Sitengwu/IOT_Retro_Display_EEE4022S/3D Models/SplitFlap/Hour MainV2.3mf

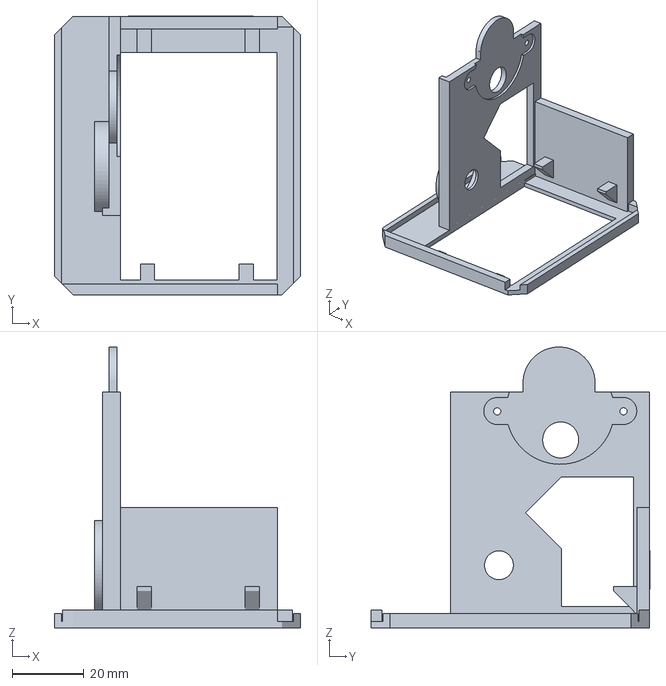
[picture p1: CAD file, 2024-11-08]
3D Models/SplitFlap/Hour MainV2.3mf
68.4 x 77.4 x 78.1 mm
