Sitengwu/IOT_Retro_Display_EEE4022S/3D Models/SplitFlap/STL/Hour Main.stl

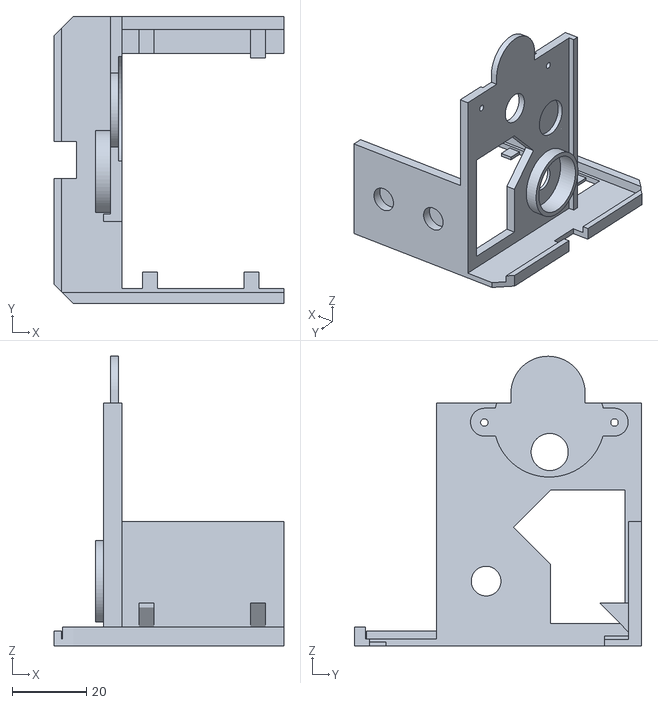
[picture p2: CAD file, 2024-11-08]
3D Models/SplitFlap/STL/Hour Main.stl
62.0 x 77.4 x 78.1
