Sitengwu/IOT_Retro_Display_EEE4022S/3D Models/SplitFlap/STL/Middle Gear Shaft Cap.stl

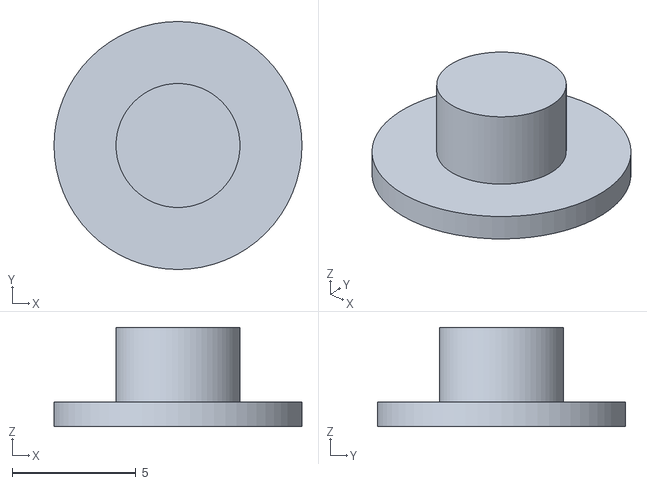
[picture p3: CAD file, 2024-11-08]
3D Models/SplitFlap/STL/Middle Gear Shaft Cap.stl
10.0 x 10.0 x 4.00
