Sitengwu/IOT_Retro_Display_EEE4022S/3D Models/LIXIE/STL/PowerModuleHousing.stl

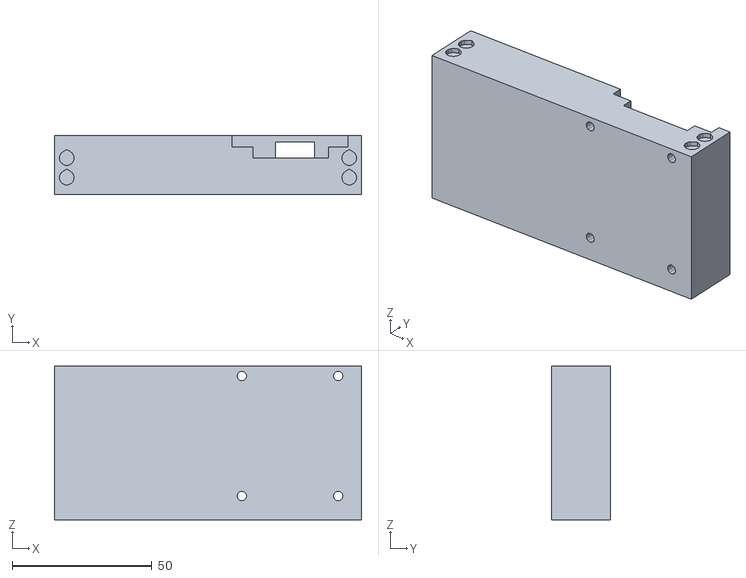
[picture p4: CAD file, 2024-11-08]
3D Models/LIXIE/STL/PowerModuleHousing.stl
110.0 x 21.0 x 55.0
