Sitengwu/IOT_Retro_Display_EEE4022S/3D Models/SplitFlap/STL/Motor Gear.stl

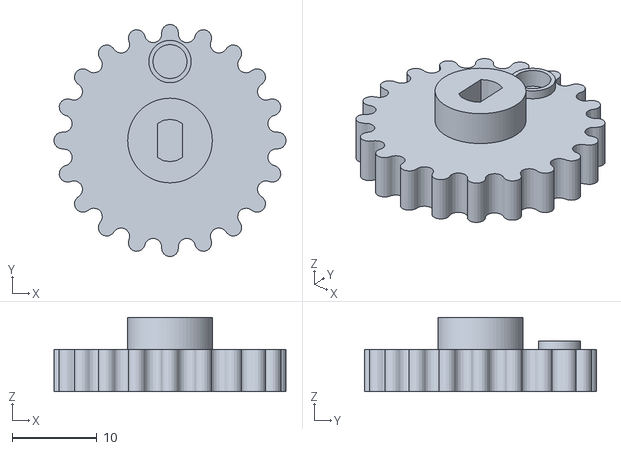
[picture p5: CAD file, 2024-11-08]
3D Models/SplitFlap/STL/Motor Gear.stl
27.4 x 27.4 x 8.80
