Sitengwu/IOT_Retro_Display_EEE4022S/3D Models/LIXIE/STL/DisplayModuleHousing.stl

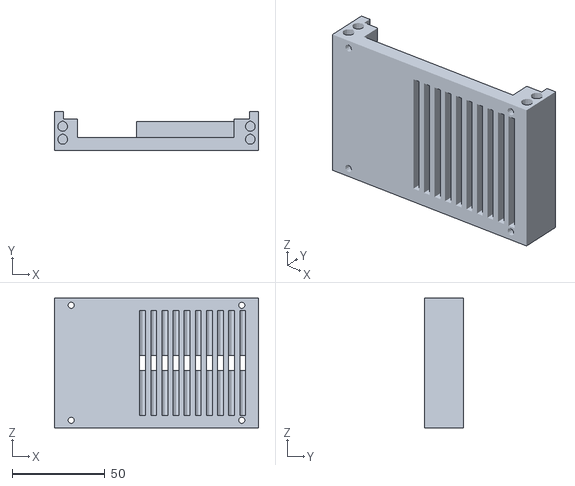
[picture p7: CAD file, 2024-11-08]
3D Models/LIXIE/STL/DisplayModuleHousing.stl
110.0 x 21.0 x 70.0
