Sitengwu/IOT_Retro_Display_EEE4022S/3D Models/SplitFlap/STL/Min-tens Flap.stl

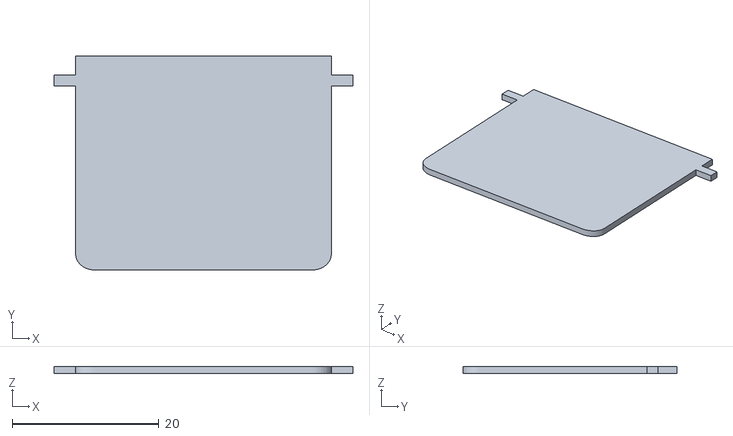
[picture p8: CAD file, 2024-11-08]
3D Models/SplitFlap/STL/Min-tens Flap.stl
40.8 x 29.2 x 1
