Sitengwu/IOT_Retro_Display_EEE4022S/3D Models/LIXIE/STL/DisplayModuleHousingCapV2.stl

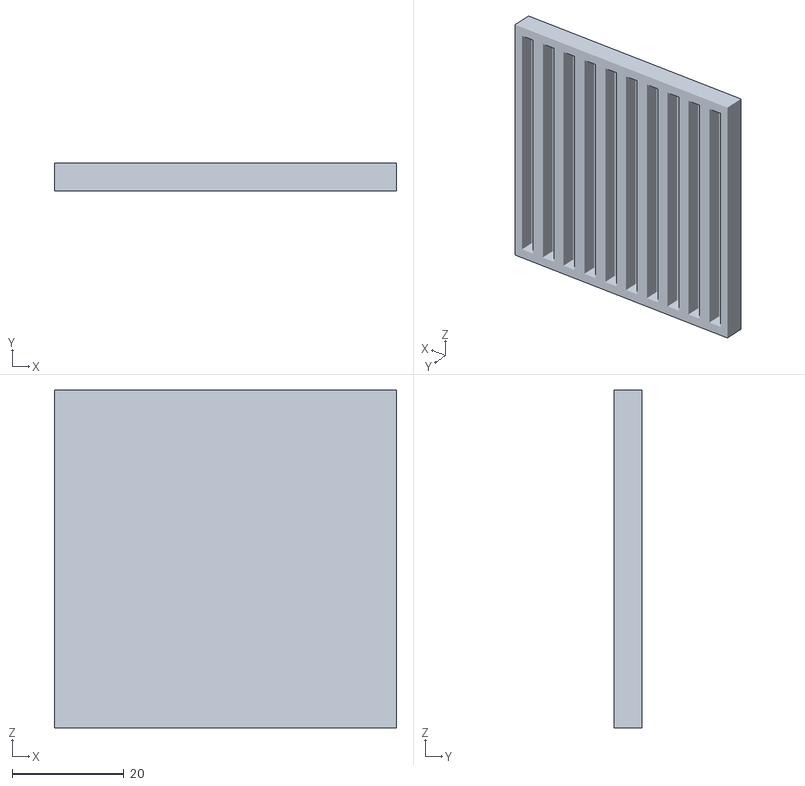
[picture p9: CAD file, 2024-11-08]
3D Models/LIXIE/STL/DisplayModuleHousingCapV2.stl
61.2 x 5.00 x 60.4
