Sitengwu/IOT_Retro_Display_EEE4022S/3D Models/SplitFlap/STL/Hour Crank.stl

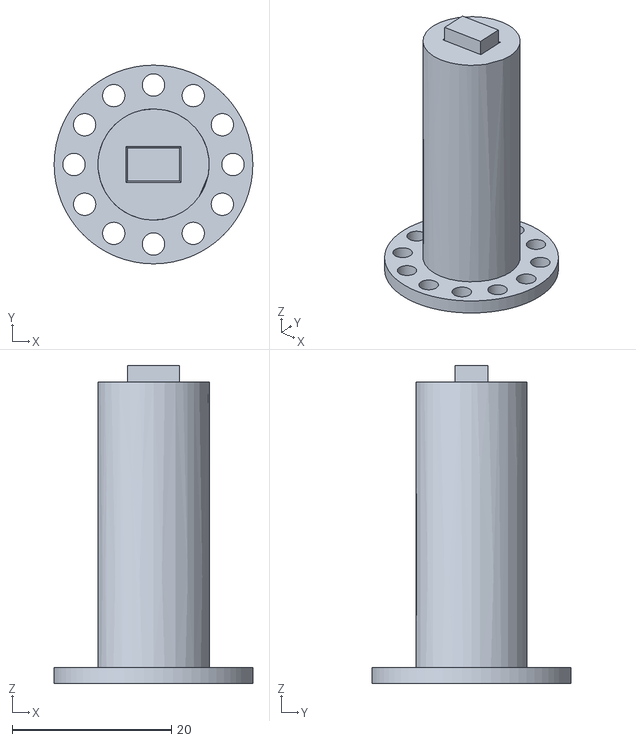
[picture p10: CAD file, 2024-11-08]
3D Models/SplitFlap/STL/Hour Crank.stl
25.0 x 25.0 x 40.0
