Sitengwu/IOT_Retro_Display_EEE4022S/3D Models/LIXIE/STL/DisplayModuleHousingV2.stl

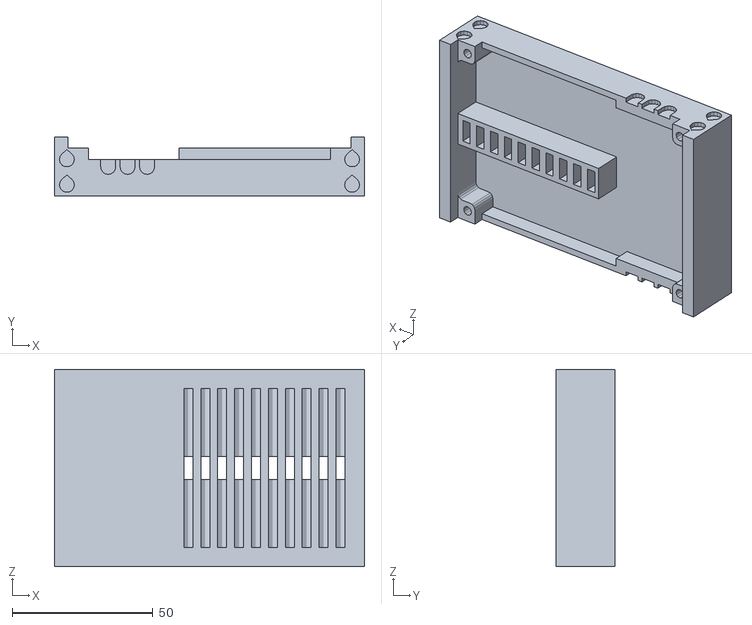
[picture p11: CAD file, 2024-11-08]
3D Models/LIXIE/STL/DisplayModuleHousingV2.stl
110.0 x 21.0 x 70.0
