Sitengwu/IOT_Retro_Display_EEE4022S/3D Models/SplitFlap/STL/Mintens Crank Close.stl

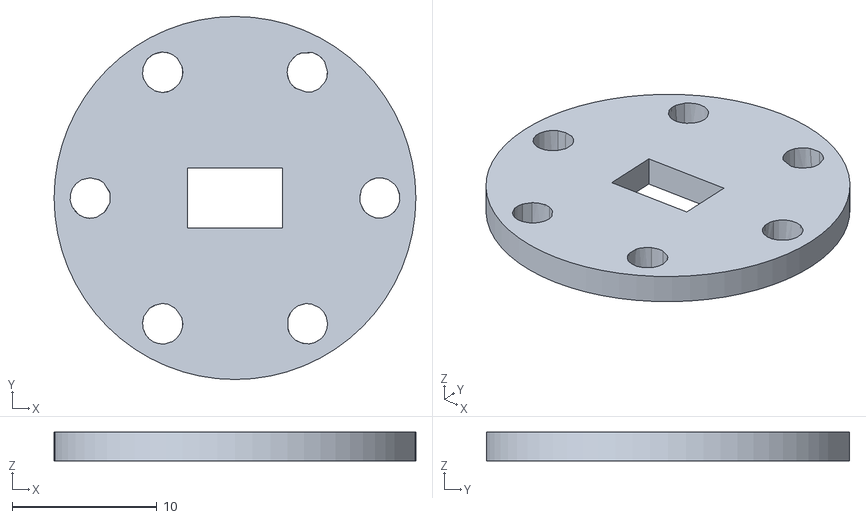
[picture p12: CAD file, 2024-11-08]
3D Models/SplitFlap/STL/Mintens Crank Close.stl
25.0 x 25.1 x 2.00
