Sitengwu/IOT_Retro_Display_EEE4022S/3D Models/SplitFlap/STL/Middle Gear.stl

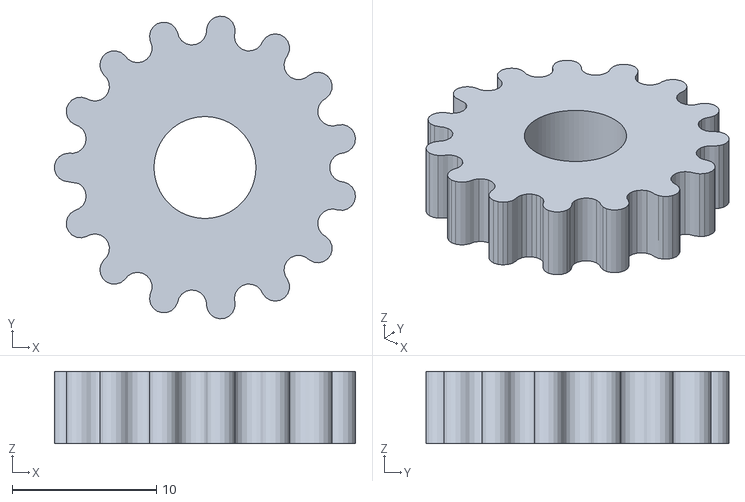
[picture p13: CAD file, 2024-11-08]
3D Models/SplitFlap/STL/Middle Gear.stl
20.9 x 21.0 x 5.00
