Sitengwu/IOT_Retro_Display_EEE4022S/3D Models/SplitFlap/STL/Crank Gear.stl

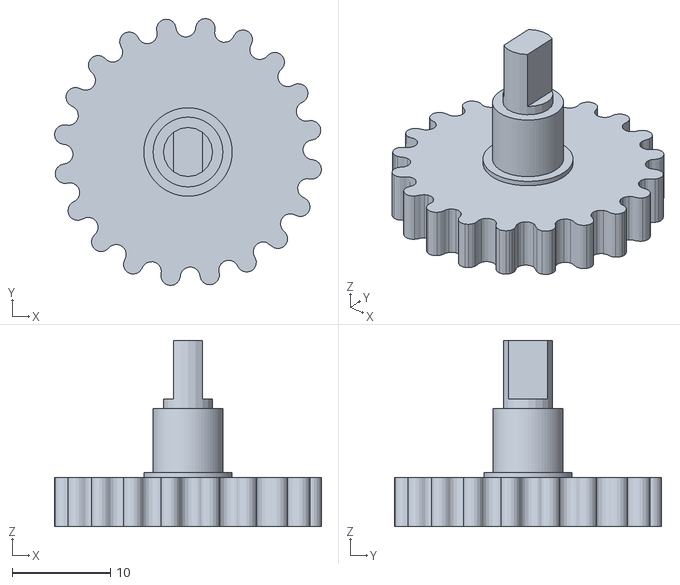
[picture p14: CAD file, 2024-11-08]
3D Models/SplitFlap/STL/Crank Gear.stl
27.2 x 27.2 x 19.0
