Sitengwu/IOT_Retro_Display_EEE4022S/3D Models/SplitFlap/STL/Hour Flap.stl

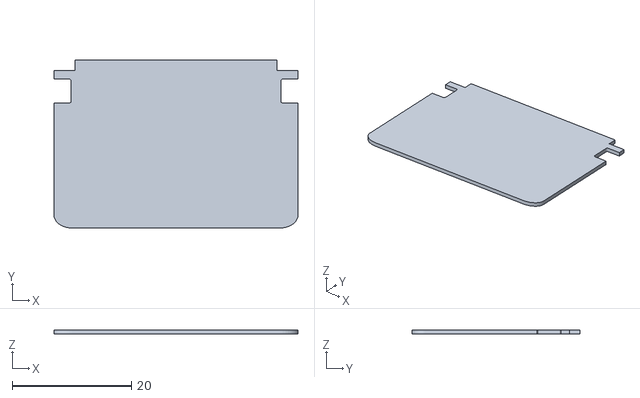
[picture p15: CAD file, 2024-11-08]
3D Models/SplitFlap/STL/Hour Flap.stl
41.0 x 28.2 x 0.75
