Sitengwu/IOT_Retro_Display_EEE4022S/3D Models/SplitFlap/STL/Bottom Plate.stl

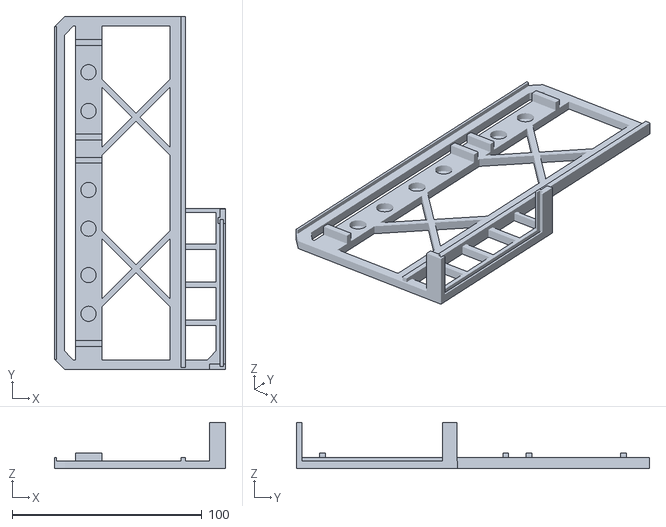
[picture p16: CAD file, 2024-11-08]
3D Models/SplitFlap/STL/Bottom Plate.stl
90.3 x 186.1 x 24.5
