Sitengwu/IOT_Retro_Display_EEE4022S/3D Models/SplitFlap/STL/Min Flap.stl

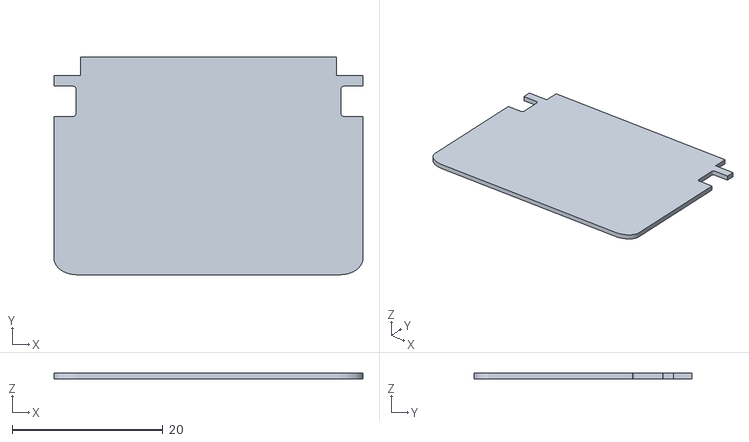
[picture p17: CAD file, 2024-11-08]
3D Models/SplitFlap/STL/Min Flap.stl
41.0 x 28.9 x 0.75
