Sitengwu/IOT_Retro_Display_EEE4022S/3D Models/SplitFlap/STL/Middle Gear Shaft.stl

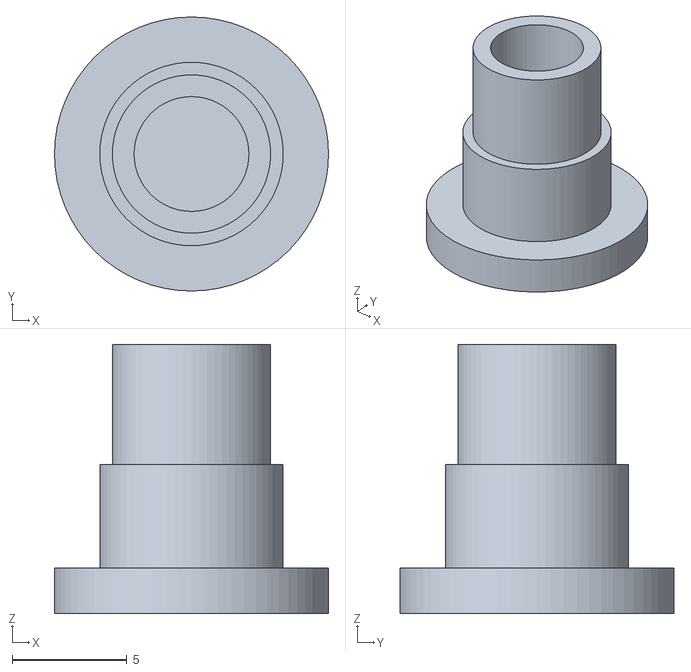
[picture p18: CAD file, 2024-11-08]
3D Models/SplitFlap/STL/Middle Gear Shaft.stl
11.9 x 11.9 x 11.8
