Sitengwu/IOT_Retro_Display_EEE4022S/3D Models/SplitFlap/STL/Hour FlapV2.stl

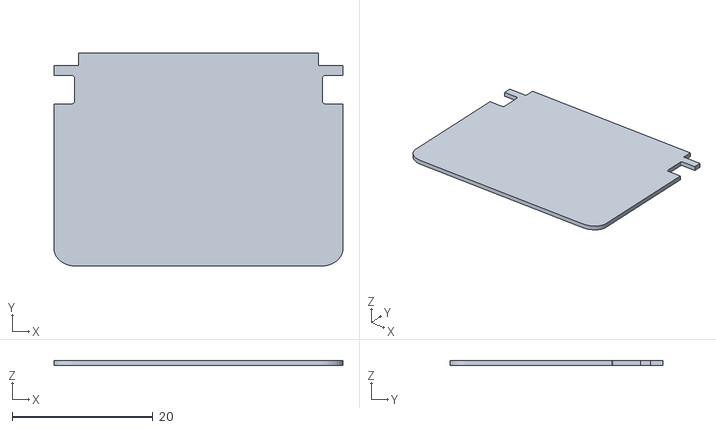
[picture p19: CAD file, 2024-11-08]
3D Models/SplitFlap/STL/Hour FlapV2.stl
41.0 x 30.2 x 0.75
