Sitengwu/IOT_Retro_Display_EEE4022S/3D Models/SplitFlap/STL/Mintens Crank.stl

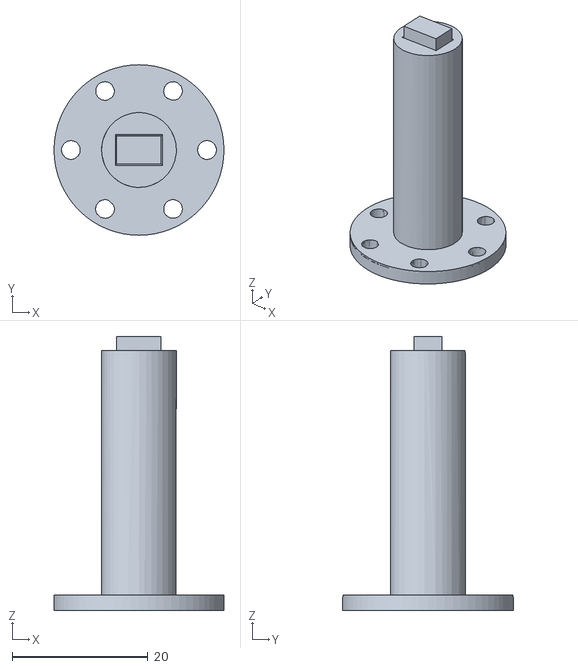
[picture p20: CAD file, 2024-11-08]
3D Models/SplitFlap/STL/Mintens Crank.stl
25.0 x 25.1 x 40.3
