Sitengwu/IOT_Retro_Display_EEE4022S/(list of files, cad)

Other CAD files:
3D Models/SplitFlap/STL/Mintens Main.stl
3D Models/LIXIE/Inventor IPT/789_Lines.dwg
3D Models/LIXIE/Inventor IPT/789outline.dwg
3D Models/LIXIE/Inventor IPT/Numbers.dwg
3D Models/LIXIE/Inventor IPT/NumbersV2.dwg
3D Models/LIXIE/Inventor IPT/789_frame.dwg
3D Models/LIXIE/Inventor IPT/NumbersFrame.dwg
3D Models/LIXIE/Inventor IPT/NumbersV2 Lines.dwg
3D Models/SplitFlap/STL/Hour Crank Close.stl
3D Models/LIXIE/Inventor IPT/789_Lines.ipt
3D Models/LIXIE/Inventor IPT/789_frame.ipt
3D Models/LIXIE/Inventor IPT/789outline.ipt
3D Models/LIXIE/Inventor IPT/AcrylicPane.ipt
3D Models/LIXIE/Inventor IPT/DisplayModuleAssembly.iam
3D Models/LIXIE/Inventor IPT/DisplayModuleHousing.ipt
3D Models/LIXIE/Inventor IPT/DisplayModuleHousingCap.ipt
3D Models/LIXIE/Inventor IPT/Numbers.ipt
3D Models/LIXIE/Inventor IPT/NumbersFrame.ipt
3D Models/LIXIE/Inventor IPT/NumbersV2 Lines.ipt
3D Models/LIXIE/Inventor IPT/NumbersV2.ipt
3D Models/LIXIE/Inventor IPT/PowerModuleHousing.ipt
3D Models/LIXIE/STL/DisplayModuleHousingCapV1.stl
3D Models/SplitFlap/STL/Hour MainV2.stl
