Sitengwu/IOT_Retro_Display_EEE4022S/KiCad/Panelised_PD+Display/NB Instructions.txt

Please select under PCB specifications: 

Different Designs:	2
Delivery Format:	Panel by Customer

Under PCB Assembly:

Tooling Holes: 		Added by Customer
