Sitengwu/IOT_Retro_Display_EEE4022S/KiCad/USB PD/USB PD.kicad_pcb

## KiCad design KiCad/USB PD/USB PD.kicad_pcb (2024-11-08)

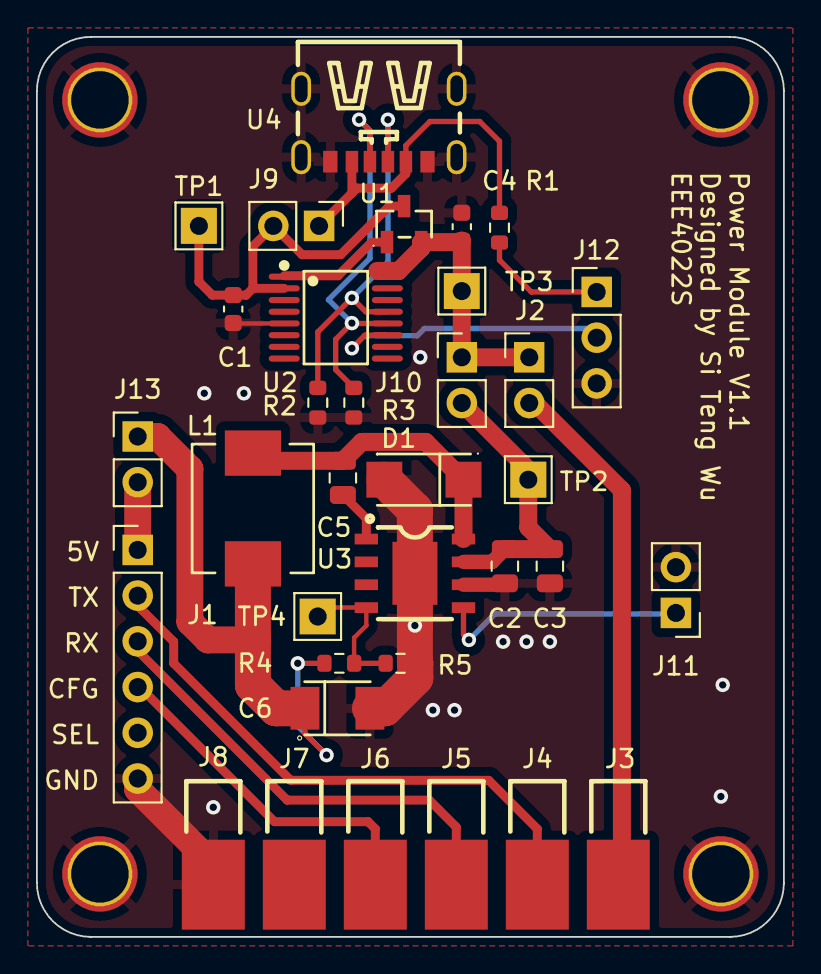
[picture p21: board USB PD.kicad_pcb from above]

Board: 2 copper layers, 41.5 x 50.0 mm, 38 parts (0 on the bottom side), 20 nets.

Parts:
C1: 1uF; C_0603_1608Metric
C2, C3: 4.7uF; C_0805_2012Metric
C4: 10uF; C_0603_1608Metric
C5: 10nF; C_0805_2012Metric
C6: 220uF; CAP-SMD_L3.5-W2.8
D1: SS34; SMA_L4.3-W2.6-LS5.2-RD
H1, H2, H3, H4: M3; MountingHole_3.2mm_M3_Pad_TopBottom
J1: ESP32 Jumpers; PinHeader_1x06_P2.54mm_Vertical
J2, J9, J10, J11, J13: Conn_01x02_Pin; PinHeader_1x02_P2.54mm_Vertical
J3: VCC; CONN-SMD_YZF0002-38080-02
J4: TX; CONN-SMD_YZF0002-38080-02
J5: RX; CONN-SMD_YZF0002-38080-02
J6: CFG; CONN-SMD_YZF0002-38080-02
J7: SEL; CONN-SMD_YZF0002-38080-02
J8: GND; CONN-SMD_YZF0002-38080-02
J12: Conn_01x03_Pin; PinHeader_1x03_P2.54mm_Vertical
L1: 22uH; IND-SMD_L7.3-W6.6_MHCI06030
R1: 100k; R_0603_1608Metric
R2, R3: 5.1k; R_0603_1608Metric
R4: 12k; R_0603_1608Metric
R5: 3.9k; R_0603_1608Metric
TP1, TP2, TP3, TP4: TestPoint; TestPoint_THTPad_2.0x2.0mm_Drill1.0mm
U1: AO3400A; SOT-23-3_L2.9-W1.3-P1.90-LS2.4-BR
U2: IP2721; TSSOP-16_L5.0-W4.4-P0.65-LS6.4-BL
U3: TPS5430DDAR; ESOP-8_L4.9-W3.9-P1.27-LS6.0-TL-EP
U4: TYPE-C_6P; TYPE-C-SMD_TYPE-C-6P

Connections:
/5V OUT: J1.1, J13.2
/USB_C_VIN: J9.1, R1.1, U4.A9 (VBUS), U4.B9 (VBUS)
/USB_C_VOUT: C4.1, J2.1, J10.1, TP3.1, U1.2 (S), U2.16 (VBUS)
GND: C1.2, C2.2, C3.2, C4.2, C6.2, D1.2 (A), H1.1, H2.1, H3.1, H4.1, J1.6, J8.1, J11.2, J12.3, R2.2, R3.2, R5.2, U2.5 (GND), U3.6 (GND), U3.9 (PowerPAD), U4.7 (EH), U4.A12 (GND), U4.B12 (GND)
unnamed: C5.1, D1.1 (K), L1.1, U3.8 (PH)
unnamed: J1.2, J4.1
unnamed: J1.3, J5.1
unnamed: J1.4, J6.1
unnamed: J2.2, J3.1
unnamed: C1.1, J9.2, TP1.1, U1.3 (D), U2.2 (VIN)
unnamed: C2.1, C3.1, J10.2, TP2.1, U3.7 (VIN)
unnamed: J11.1, U3.5 (ENA)
unnamed: J12.1, R1.2
unnamed: J12.2, U2.11 (SEL)
unnamed: C6.1, J13.1, L1.2, R4.1
unnamed: U1.1 (G), U2.1 (VBUSG)
unnamed: R2.1, U2.13 (CC1), U4.A5 (CC1)
unnamed: R3.1, U2.12 (CC2), U4.B5 (CC2)
unnamed: C5.2, U3.1 (BOOT)
unnamed: R4.2, R5.1, TP4.1, U3.4 (VSENSE)
