Sitengwu/IOT_Retro_Display_EEE4022S/KiCad/Retro Display Module/Retro Display Module.kicad_pcb

## KiCad design KiCad/Retro Display Module/Retro Display Module.kicad_pcb (2024-10-01)

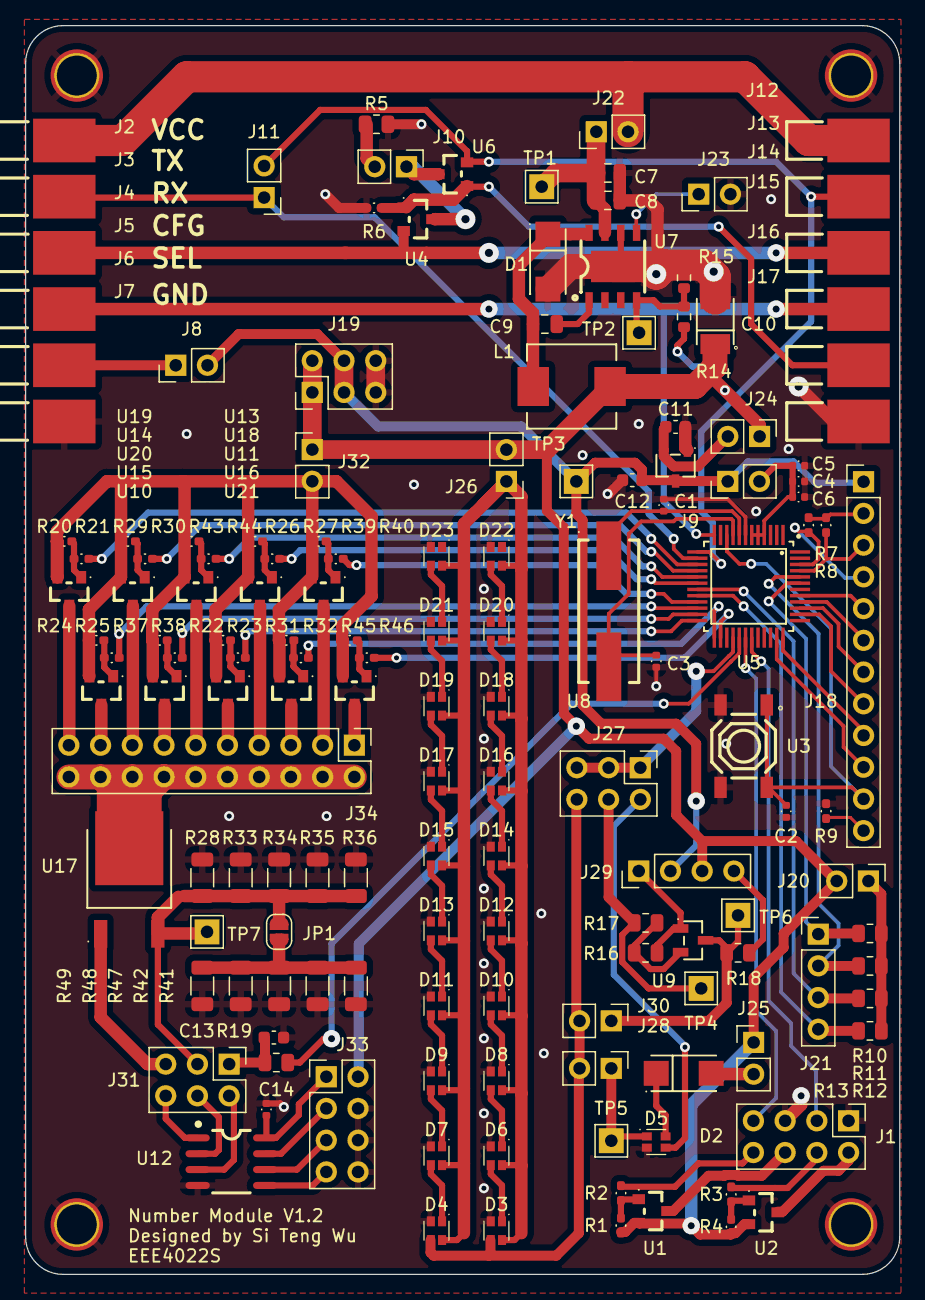
[picture p22: board Retro Display Module.kicad_pcb from above]

Board: 2 copper layers, 70.0 x 100.0 mm, 155 parts (0 on the bottom side), 119 nets.

Parts:
C1, C3: 10pF; C_0402_1005Metric
C2, C4, C6, C14: 0.1uF; C_0402_1005Metric
C5: 4.7uF; C_0402_1005Metric
C7, C8: 4.7uF; C_0805_2012Metric
C9: 10nF; C_0805_2012Metric
C10: 220uF; CAP-SMD_L3.5-W2.8
C11, C12, C13: 1uF; C_0603_1608Metric
D1: SS34; SMA_L4.3-W2.6-LS5.2-RD
D2: M7; SMA_L4.3-W2.6-LS5.2-RD
D3, D4, D5, D6, D7, D8, D9, D10, D11, D12, D13, D14, D15, D16, D17, D18, D19, D20, D21, D22, D23: XL-1615RGBC-WS2812B; LED-SMD_4P-L1.6-W1.5_XL-1615RGBC-WS2812B
H1, H2, H3, H4: M3; MountingHole_3.2mm_M3_Pad_TopBottom
J1, J33: Conn_02x04_Odd_Even; PinHeader_2x04_P2.54mm_Vertical
J2, J12: VCC; CONN-SMD_YZF0002-38080-02
J3, J13: TX; CONN-SMD_YZF0002-38080-02
J4, J14: RX; CONN-SMD_YZF0002-38080-02
J5, J15: CFG; CONN-SMD_YZF0002-38080-02
J6, J16: SEL; CONN-SMD_YZF0002-38080-02
J7, J17: GND; CONN-SMD_YZF0002-38080-02
J8, J9, J10, J11, J20, J22, J23, J24, J25, J26, J28, J30, J32: Conn_01x02_Pin; PinHeader_1x02_P2.54mm_Vertical
J18: Conn_01x12_Pin; PinHeader_1x12_P2.54mm_Vertical
J19, J27, J31: Conn_02x03_Odd_Even; PinHeader_2x03_P2.54mm_Vertical
J21, J29: Conn_01x04_Pin; PinHeader_1x04_P2.54mm_Vertical
J34: Conn_02x11_Odd_Even; PinHeader_2x10_P2.54mm_Vertical
JP1: Jumper_2_Open; SolderJumper-2_P1.3mm_Open_RoundedPad1.0x1.5mm
L1: 22uH; IND-SMD_L7.3-W6.6_MHCI06030
R1, R4, R6, R20, R22, R24, R26, R29, R31, R37, R39, R43, R45: 100k; R_0402_1005Metric_Pad0.72x0.64mm_HandSolder
R2, R3, R21, R23, R25, R27, R30, R32, R38, R40, R44, R46: 1k; R_0402_1005Metric_Pad0.72x0.64mm_HandSolder
R5, R16, R17, R18: 1k; R_0805_2012Metric
R7, R8, R9: 10k; R_0402_1005Metric_Pad0.72x0.64mm_HandSolder
R10, R11, R12, R13: 4.7k; R_0805_2012Metric
R14: 12k; R_0603_1608Metric
R15: 3.9k; R_0603_1608Metric
R19: 10k; R_0805_2012Metric
R28, R33, R34, R35, R36, R41, R42, R47, R48, R49: 100; R_1206_3216Metric
TP1, TP2, TP3, TP4, TP5, TP6, TP7: TestPoint; TestPoint_THTPad_2.0x2.0mm_Drill1.0mm
U1, U2, U4, U6, U10, U11, U13, U14, U15, U16, U18, U19, U20, U21: AO3401A; SOT-23_L2.9-W1.3-P1.90-LS2.4-BR
U3: TS-1187A-B-A-B; SW-SMD_4P-L5.1-W5.1-P3.70-LS6.5-TL-2
U5: STM32G030C8T6; LQFP-48_L7.0-W7.0-P0.50-LS9.0-BL_1
U7: TPS5430DDAR; ESOP-8_L4.9-W3.9-P1.27-LS6.0-TL-EP
U8: XC6206P332MR; XC6206
U9: 2N7002; SOT-23-3_L2.9-W1.3-P1.90-LS2.4-BR
U12: LM358DR2G; Dual LM358
U17: MJD44H11J; MJD44 NPN
Y1: Crystal; CRYSTAL-SMD_L11.5-W4.8-LS12.7

Connections:
/3V3: C12.1, J8.2, J9.1, J18.1, J19.3, J19.4, J29.2, TP3.1, U8.3 (Vout)
/5V: C10.1, J19.1, J19.2, J20.2, J24.1, J25.1, J26.2, J29.3, J32.1, J33.2, L1.2, R1.1, R4.1, R14.1, U1.2 (S), U2.2 (S)
/I2C1_SCL: J18.3, R8.2, U5.45 (PB6)
/I2C1_SDA: J18.4, R7.2, U5.46 (PB7)
/I2C_PUR: J18.2, R7.1, R8.1
/LED Driver/1OUT: J31.5, U17.1 (B)
/LED Driver/5V_PWR: J32.2, R20.1, R22.1, R24.1, R26.1, R29.1, R31.1, R37.1, R39.1, R43.1, R45.1, U10.2 (S), U11.2 (S), U13.2 (S), U14.2 (S), U15.2 (S), U16.2 (S), U18.2 (S), U19.2 (S), U20.2 (S), U21.2 (S)
/LED Driver/-ve: J31.3, JP1.1 (A), R28.1, R33.1, R34.1, R35.1, R36.1, TP7.1, U17.3 (E)
/LED Driver/LED0: J34.1, U21.3 (D)
/LED Driver/LED1: J34.19, U10.3 (D)
/LED Driver/LED2: J34.17, U13.3 (D)
/LED Driver/LED3: J34.15, U15.3 (D)
/LED Driver/LED4: J34.13, U18.3 (D)
/LED Driver/LED5: J34.11, U20.3 (D)
/LED Driver/LED6: J34.9, U11.3 (D)
/LED Driver/LED7: J34.7, U14.3 (D)
/LED Driver/LED8: J34.5, U16.3 (D)
/LED Driver/LED9: J34.3, U19.3 (D)
/LED Driver/main_col: J34.2, J34.4, J34.6, J34.8, J34.10, J34.12, J34.14, J34.16, J34.18, J34.20, U17.2 (C)
/NRST: C2.1, J18.11, U3.1 (A), U3.2 (B), U5.10 (NRST)
/PA1: J5.1, J15.1, U5.12 (PA1)
/PA4: R21.2, U5.15 (PA4)
/PA5: R30.2, U5.16 (PA5)
/PA6: R44.2, U5.17 (PA6)
/PA7: R27.2, U5.18 (PA7)
/PB2: R40.2, U5.21 (PB2)
/PB10: R25.2, U5.22 (PB10)
/PB11: R38.2, U5.23 (PB11)
/PB12: R23.2, U5.24 (PB12)
/PB13: R32.2, U5.25 (PB13)
/PB14: R46.2, U5.26 (PB14)
/PC6: J1.8, R2.2
/PC7: J1.4, R3.2
/PD1: J18.7, U5.39 (PD1)
/PD2: J18.6, U5.40 (PD2)
/PD3: J18.5, U5.41 (PD3)
/PDO: J18.8, U5.38 (PD0)
/RGB LEDs/Cheese: D5.4 (DI), J27.2
/RGB LEDs/DIN: D3.4 (DI), D4.4 (DI), J27.6, J28.2, J30.2
/RGB LEDs/Level: J27.4, R16.2, TP4.1
/SWDCLK/BOOT: J18.9, U5.36 (PA14-BOOT0)
/SWDIO: J18.10, U5.35 (PA13)
/TIM1_CH1: J27.1, J27.3, J27.5, U5.28 (PA8)
/TIM1_CH2: R19.2, U5.29 (PA9)
/TIM3_CH1: J21.1, R10.2, U5.43 (PB4)
/TIM3_CH2: J21.2, R11.2, U5.44 (PB5)
/TIM3_CH3: J21.3, R12.2, U5.19 (PB0)
/TIM3_CH4: J21.4, R13.2, U5.20 (PB1)
/USART2_Rx: J3.1, J11.1, U5.14 (PA3)
/USART2_Tx: J11.2, J13.1, U5.13 (PA2), U6.2 (S)
/VCC: J2.1, J12.1, J22.2
/VR/B: C4.1, C5.1, C6.1, J9.2, U5.4 (VBAT), U5.5 (VREF+), U5.6 (VDDA/DDA)
GND: C1.2, C2.2, C3.2, C4.2, C5.2, C6.2, C7.2, C8.2, C10.2, C11.2, C12.2, C13.2, C14.2, D1.2 (A), D3.3 (GND), D4.3 (GND), D5.3 (GND), D6.3 (GND), D7.3 (GND), D8.3 (GND), D9.3 (GND), D10.3 (GND), D11.3 (GND), D12.3 (GND), D13.3 (GND), D14.3 (GND), D15.3 (GND), D16.3 (GND), D17.3 (GND), D18.3 (GND), D19.3 (GND), D20.3 (GND), D21.3 (GND), D22.3 (GND), D23.3 (GND), H1.1, H2.1, H3.1, H4.1, J1.1, J1.5, J7.1, J17.1, J19.5, J19.6, J23.2, J33.4, J33.6, J33.8, R5.2, R6.2, R9.1, R15.2, R28.2, R33.2, R34.2, R35.2, R36.2, R41.2, R42.2, R47.2, R48.2, R49.2, U3.3 (C), U3.4 (D), U5.7 (VSSA/SSA), U7.6 (GND), U7.9 (PowerPAD), U8.1 (GND), U12.4 (GND)
unnamed: C9.1, D1.1 (K), L1.1, U7.8 (PH)
unnamed: D2.2 (A), J25.2
unnamed: D2.1 (K), D5.2 (VDD)
unnamed: D3.1 (DO), D6.4 (DI)
unnamed: D4.1 (DO), D7.4 (DI)
unnamed: D5.1 (DO), J28.1, TP5.1
unnamed: D6.1 (DO), D8.4 (DI)
unnamed: D7.1 (DO), D9.4 (DI)
unnamed: D8.1 (DO), D10.4 (DI)
unnamed: D10.1 (DO), D12.4 (DI)
unnamed: D3.2 (VDD), D4.2 (VDD), D6.2 (VDD), D7.2 (VDD), D8.2 (VDD), D9.2 (VDD), D10.2 (VDD), D11.2 (VDD), D12.2 (VDD), D13.2 (VDD), D14.2 (VDD), D15.2 (VDD), D16.2 (VDD), D17.2 (VDD), D18.2 (VDD), D19.2 (VDD), D20.2 (VDD), D21.2 (VDD), D22.2 (VDD), D23.2 (VDD), J26.1
unnamed: D9.1 (DO), D11.4 (DI)
unnamed: D11.1 (DO), D13.4 (DI)
unnamed: D12.1 (DO), D14.4 (DI)
unnamed: D13.1 (DO), D15.4 (DI)
unnamed: D14.1 (DO), D16.4 (DI)
unnamed: D15.1 (DO), D17.4 (DI)
unnamed: D16.1 (DO), D18.4 (DI)
unnamed: D17.1 (DO), D19.4 (DI)
unnamed: D18.1 (DO), D20.4 (DI)
unnamed: D19.1 (DO), D21.4 (DI)
unnamed: D20.1 (DO), D22.4 (DI)
unnamed: D21.1 (DO), D23.4 (DI)
unnamed: J1.2, U2.3 (D)
unnamed: J1.3, U5.31 (PC7)
unnamed: J1.6, U1.3 (D)
unnamed: J1.7, U5.30 (PC6)
unnamed: J6.1, J8.1
unnamed: J10.1, U4.3 (D), U6.3 (D)
unnamed: J10.2, R5.1
unnamed: J4.1, J14.1, U4.2 (S)
unnamed: J16.1, R6.1, U4.1 (G), U6.1 (G)
unnamed: J18.12, R9.2
unnamed: J20.1, R10.1, R11.1, R12.1, R13.1
unnamed: C7.1, C8.1, J22.1, TP1.1, U7.7 (VIN)
unnamed: J23.1, U7.5 (ENA)
unnamed: C11.1, J24.2, U8.2 (Vin)
unnamed: J29.1, R17.2, U9.1 (G)
unnamed: J29.4, R18.2
unnamed: J30.1, R18.1, TP6.1, U9.3 (D)
unnamed: C13.1, J31.1, R19.1
unnamed: J31.2, U12.3 (1IN+)
unnamed: J31.4, U12.2 (1IN-)
unnamed: J31.6, U12.1 (1OUT)
unnamed: C14.1, J33.1, U12.8 (VCC)
unnamed: J33.3, U12.7 (2OUT)
unnamed: J33.5, U12.6 (2IN-)
unnamed: J33.7, U12.5 (2IN+)
unnamed: JP1.2 (B), R41.1, R42.1, R47.1, R48.1, R49.1
unnamed: R1.2, R2.1, U1.1 (G)
unnamed: R3.1, R4.2, U2.1 (G)
unnamed: C1.1, U5.8 (PF0-OSC_IN), Y1.1
unnamed: C3.1, U5.9 (PF1-OSC_OUT), Y1.2
unnamed: C9.2, U7.1 (BOOT)
unnamed: R14.2, R15.1, TP2.1, U7.4 (VSENSE)
unnamed: R16.1, R17.1, U9.2 (S)
unnamed: R20.2, R21.1, U10.1 (G)
unnamed: R22.2, R23.1, U11.1 (G)
unnamed: R24.2, R25.1, U13.1 (G)
unnamed: R26.2, R27.1, U14.1 (G)
unnamed: R29.2, R30.1, U15.1 (G)
unnamed: R31.2, R32.1, U16.1 (G)
unnamed: R37.2, R38.1, U18.1 (G)
unnamed: R39.2, R40.1, U19.1 (G)
unnamed: R43.2, R44.1, U20.1 (G)
unnamed: R45.2, R46.1, U21.1 (G)
