Sitengwu/IOT_Retro_Display_EEE4022S/KiCad/Panelised_PD+Display/Panelised_PD+Display.kicad_pcb

## KiCad design KiCad/Panelised_PD+Display/Panelised_PD+Display.kicad_pcb (2024-10-01)

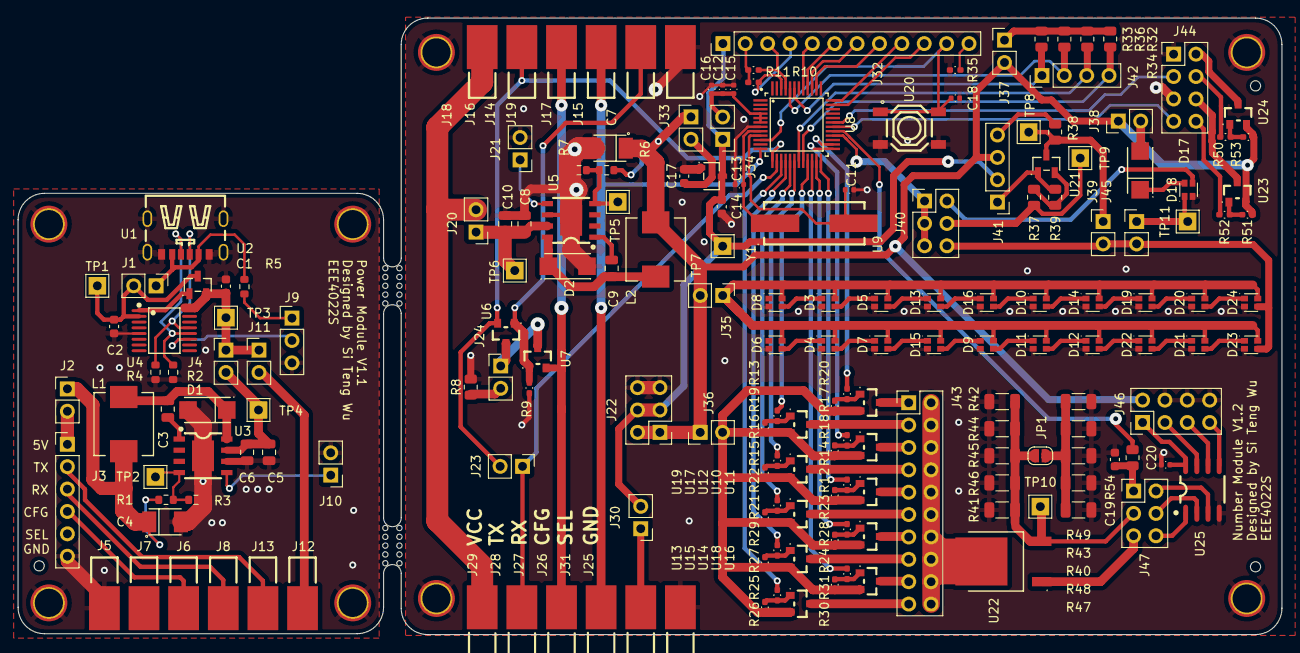
[picture p23: board Panelised_PD+Display.kicad_pcb from above]

Board: 2 copper layers, 143.5 x 70.0 mm, 195 parts (0 on the bottom side), 133 nets.

Parts:
C1: 10uF; C_0603_1608Metric
C2, C14, C17, C19: 1uF; C_0603_1608Metric
C3, C9: 10nF; C_0805_2012Metric
C4, C7: 220uF; CAP-SMD_L3.5-W2.8
C5, C6, C8, C10: 4.7uF; C_0805_2012Metric
C11, C13: 10pF; C_0402_1005Metric
C12, C15, C18, C20: 0.1uF; C_0402_1005Metric
C16: 4.7uF; C_0402_1005Metric
D1, D2: SS34; SMA_L4.3-W2.6-LS5.2-RD
D3, D4, D5, D6, D7, D8, D9, D10, D11, D12, D13, D14, D15, D16, D18, D19, D20, D21, D22, D23, D24: XL-1615RGBC-WS2812B; LED-SMD_4P-L1.6-W1.5_XL-1615RGBC-WS2812B
D17: M7; SMA_L4.3-W2.6-LS5.2-RD
H1, H2, H3, H4, H5, H6, H7, H8: M3; MountingHole_3.2mm_M3_Pad_TopBottom
J1, J2, J4, J10, J11, J20, J21, J23, J24, J30, J33, J34, J35, J36, J37, J38, J39, J45: Conn_01x02_Pin; PinHeader_1x02_P2.54mm_Vertical
J3: ESP32 Jumpers; PinHeader_1x06_P2.54mm_Vertical
J5, J15, J25: GND; CONN-SMD_YZF0002-38080-02
J6, J19, J26: CFG; CONN-SMD_YZF0002-38080-02
J7, J17, J31: SEL; CONN-SMD_YZF0002-38080-02
J8, J14, J27: RX; CONN-SMD_YZF0002-38080-02
J9: Conn_01x03_Pin; PinHeader_1x03_P2.54mm_Vertical
J12, J18, J29: VCC; CONN-SMD_YZF0002-38080-02
J13, J16, J28: TX; CONN-SMD_YZF0002-38080-02
J22, J40, J47: Conn_02x03_Odd_Even; PinHeader_2x03_P2.54mm_Vertical
J32: Conn_01x12_Pin; PinHeader_1x12_P2.54mm_Vertical
J41, J42: Conn_01x04_Pin; PinHeader_1x04_P2.54mm_Vertical
J43: Conn_02x11_Odd_Even; PinHeader_2x10_P2.54mm_Vertical
J44, J46: Conn_02x04_Odd_Even; PinHeader_2x04_P2.54mm_Vertical
JP1: Jumper_2_Open; SolderJumper-2_P1.3mm_Open_RoundedPad1.0x1.5mm
L1, L2: 22uH; IND-SMD_L7.3-W6.6_MHCI06030
R1, R6: 12k; R_0603_1608Metric
R2, R4: 5.1k; R_0603_1608Metric
R3, R7: 3.9k; R_0603_1608Metric
R5: 100k; R_0603_1608Metric
R8, R37, R38, R39: 1k; R_0805_2012Metric
R9, R14, R15, R17, R19, R21, R23, R24, R26, R27, R30, R51, R53: 100k; R_0402_1005Metric_Pad0.72x0.64mm_HandSolder
R10, R11, R35: 10k; R_0402_1005Metric_Pad0.72x0.64mm_HandSolder
R12, R13, R16, R18, R20, R22, R25, R28, R29, R31, R50, R52: 1k; R_0402_1005Metric_Pad0.72x0.64mm_HandSolder
R32, R33, R34, R36: 4.7k; R_0805_2012Metric
R40, R41, R42, R43, R44, R45, R46, R47, R48, R49: 100; R_1206_3216Metric
R54: 10k; R_0805_2012Metric
TP1, TP2, TP3, TP4, TP5, TP6, TP7, TP8, TP9, TP10, TP11: TestPoint; TestPoint_THTPad_2.0x2.0mm_Drill1.0mm
U1: TYPE-C_6P; TYPE-C-SMD_TYPE-C-6P
U2: AO3400A; SOT-23-3_L2.9-W1.3-P1.90-LS2.4-BR
U3, U5: TPS5430DDAR; ESOP-8_L4.9-W3.9-P1.27-LS6.0-TL-EP
U4: IP2721; TSSOP-16_L5.0-W4.4-P0.65-LS6.4-BL
U6, U7, U10, U11, U12, U13, U14, U15, U16, U17, U18, U19, U23, U24: AO3401A; SOT-23_L2.9-W1.3-P1.90-LS2.4-BR
U8: STM32G030C8T6; LQFP-48_L7.0-W7.0-P0.50-LS9.0-BL_1
U9: XC6206P332MR; XC6206
U20: TS-1187A-B-A-B; SW-SMD_4P-L5.1-W5.1-P3.70-LS6.5-TL-2
U21: 2N7002; SOT-23-3_L2.9-W1.3-P1.90-LS2.4-BR
U22: MJD44H11J; MJD44 NPN
U25: LM358DR2G; Dual LM358
Y1: Crystal; CRYSTAL-SMD_L11.5-W4.8-LS12.7
mouse-bite-1, mouse-bite-2: VAL**; mouse-bite-2mm-slot

Connections:
/3V3: C14.1, J22.3, J22.4, J30.2, J32.1, J34.1, J41.2, TP7.1, U9.3 (Vout)
/5V: C7.1, J22.1, J22.2, J33.1, J35.2, J36.1, J37.2, J38.1, J41.3, J46.2, L2.2, R6.1, R51.1, R53.1, U23.2 (S), U24.2 (S)
/5V OUT: J2.2, J3.1
/I2C1_SCL: J32.3, R10.2, U8.45 (PB6)
/I2C1_SDA: J32.4, R11.2, U8.46 (PB7)
/I2C_PUR: J32.2, R10.1, R11.1
/LED Driver/1OUT: J47.5, U22.1 (B)
/LED Driver/5V_PWR: J36.2, R14.1, R15.1, R17.1, R19.1, R21.1, R23.1, R24.1, R26.1, R27.1, R30.1, U10.2 (S), U11.2 (S), U12.2 (S), U13.2 (S), U14.2 (S), U15.2 (S), U16.2 (S), U17.2 (S), U18.2 (S), U19.2 (S)
/LED Driver/-ve: J47.3, JP1.1 (A), R41.1, R42.1, R44.1, R45.1, R46.1, TP10.1, U22.3 (E)
/LED Driver/LED0: J43.1, U11.3 (D)
/LED Driver/LED1: J43.19, U16.3 (D)
/LED Driver/LED2: J43.17, U19.3 (D)
/LED Driver/LED3: J43.15, U18.3 (D)
/LED Driver/LED4: J43.13, U17.3 (D)
/LED Driver/LED5: J43.11, U14.3 (D)
/LED Driver/LED6: J43.9, U12.3 (D)
/LED Driver/LED7: J43.7, U15.3 (D)
/LED Driver/LED8: J43.5, U10.3 (D)
/LED Driver/LED9: J43.3, U13.3 (D)
/LED Driver/main_col: J43.2, J43.4, J43.6, J43.8, J43.10, J43.12, J43.14, J43.16, J43.18, J43.20, U22.2 (C)
/NRST: C18.1, J32.11, U8.10 (NRST), U20.1 (A), U20.2 (B)
/PA1: J19.1, J26.1, U8.12 (PA1)
/PA4: R25.2, U8.15 (PA4)
/PA5: R29.2, U8.16 (PA5)
/PA6: R22.2, U8.17 (PA6)
/PA7: R16.2, U8.18 (PA7)
/PB2: R13.2, U8.21 (PB2)
/PB10: R31.2, U8.22 (PB10)
/PB11: R28.2, U8.23 (PB11)
/PB12: R12.2, U8.24 (PB12)
/PB13: R18.2, U8.25 (PB13)
/PB14: R20.2, U8.26 (PB14)
/PC6: J44.8, R52.2
/PC7: J44.4, R50.2
/PD1: J32.7, U8.39 (PD1)
/PD2: J32.6, U8.40 (PD2)
/PD3: J32.5, U8.41 (PD3)
/PDO: J32.8, U8.38 (PD0)
/RGB LEDs/Cheese: D18.4 (DI), J40.2
/RGB LEDs/DIN: D23.4 (DI), D24.4 (DI), J39.2, J40.6, J45.2
/RGB LEDs/Level: J40.4, R39.2, TP9.1
/SWDCLK/BOOT: J32.9, U8.36 (PA14-BOOT0)
/SWDIO: J32.10, U8.35 (PA13)
/TIM1_CH1: J40.1, J40.3, J40.5, U8.28 (PA8)
/TIM1_CH2: R54.2, U8.29 (PA9)
/TIM3_CH1: J42.1, R33.2, U8.43 (PB4)
/TIM3_CH2: J42.2, R36.2, U8.44 (PB5)
/TIM3_CH3: J42.3, R32.2, U8.19 (PB0)
/TIM3_CH4: J42.4, R34.2, U8.20 (PB1)
/USART2_Rx: J23.1, J28.1, U8.14 (PA3)
/USART2_Tx: J16.1, J23.2, U6.2 (S), U8.13 (PA2)
/USB_C_VIN: J1.1, R5.1, U1.A9 (VBUS), U1.B9 (VBUS)
/USB_C_VOUT: C1.1, J4.1, J11.1, TP3.1, U2.2 (S), U4.16 (VBUS)
/VCC: J18.1, J20.2, J29.1
/VR/B: C12.1, C15.1, C16.1, J34.2, U8.4 (VBAT), U8.5 (VREF+), U8.6 (VDDA/DDA)
GND: C1.2, C2.2, C4.2, C5.2, C6.2, C7.2, C8.2, C10.2, C11.2, C12.2, C13.2, C14.2, C15.2, C16.2, C17.2, C18.2, C19.2, C20.2, D1.2 (A), D2.2 (A), D3.3 (GND), D4.3 (GND), D5.3 (GND), D6.3 (GND), D7.3 (GND), D8.3 (GND), D9.3 (GND), D10.3 (GND), D11.3 (GND), D12.3 (GND), D13.3 (GND), D14.3 (GND), D15.3 (GND), D16.3 (GND), D18.3 (GND), D19.3 (GND), D20.3 (GND), D21.3 (GND), D22.3 (GND), D23.3 (GND), D24.3 (GND), H1.1, H2.1, H3.1, H4.1, H5.1, H6.1, H7.1, H8.1, J3.6, J5.1, J9.3, J10.2, J15.1, J21.2, J22.5, J22.6, J25.1, J44.1, J44.5, J46.4, J46.6, J46.8, R2.2, R3.2, R4.2, R7.2, R8.2, R35.1, R40.2, R41.2, R42.2, R43.2, R44.2, R45.2, R46.2, R47.2, R48.2, R49.2, U1.7 (EH), U1.A12 (GND), U1.B12 (GND), U3.6 (GND), U3.9 (PowerPAD), U4.5 (GND), U5.6 (GND), U5.9 (PowerPAD), U8.7 (VSSA/SSA), U9.1 (GND), U20.3 (C), U20.4 (D), U25.4 (GND)
unnamed: C3.1, C9.1, D1.1 (K), D2.1 (K), L1.1, L2.1, U3.8 (PH), U5.8 (PH)
unnamed: D17.2 (A), J38.2
unnamed: D17.1 (K), D18.2 (VDD)
unnamed: D20.4 (DI), D24.1 (DO)
unnamed: D21.4 (DI), D23.1 (DO)
unnamed: D18.1 (DO), J45.1, TP11.1
unnamed: D19.4 (DI), D20.1 (DO)
unnamed: D21.1 (DO), D22.4 (DI)
unnamed: D14.4 (DI), D19.1 (DO)
unnamed: D10.4 (DI), D14.1 (DO)
unnamed: D3.2 (VDD), D4.2 (VDD), D5.2 (VDD), D6.2 (VDD), D7.2 (VDD), D8.2 (VDD), D9.2 (VDD), D10.2 (VDD), D11.2 (VDD), D12.2 (VDD), D13.2 (VDD), D14.2 (VDD), D15.2 (VDD), D16.2 (VDD), D19.2 (VDD), D20.2 (VDD), D21.2 (VDD), D22.2 (VDD), D23.2 (VDD), D24.2 (VDD), J35.1
unnamed: D12.4 (DI), D22.1 (DO)
unnamed: D11.4 (DI), D12.1 (DO)
unnamed: D10.1 (DO), D16.4 (DI)
unnamed: D9.4 (DI), D11.1 (DO)
unnamed: D13.4 (DI), D16.1 (DO)
unnamed: D9.1 (DO), D15.4 (DI)
unnamed: D5.4 (DI), D13.1 (DO)
unnamed: D7.4 (DI), D15.1 (DO)
unnamed: D3.4 (DI), D5.1 (DO)
unnamed: D4.4 (DI), D7.1 (DO)
unnamed: D3.1 (DO), D8.4 (DI)
unnamed: D4.1 (DO), D6.4 (DI)
unnamed: J3.2, J13.1, J44.2, U24.3 (D)
unnamed: J3.3, J8.1, J44.3, U8.31 (PC7)
unnamed: J3.4, J6.1
unnamed: J44.6, U23.3 (D)
unnamed: J44.7, U8.30 (PC6)
unnamed: J11.2, J12.1
unnamed: J30.1, J31.1
unnamed: C2.1, J1.2, TP1.1, U2.3 (D), U4.2 (VIN)
unnamed: J24.1, U6.3 (D), U7.3 (D)
unnamed: C5.1, C6.1, J4.2, J24.2, R8.1, TP4.1, U3.7 (VIN)
unnamed: J10.1, U3.5 (ENA)
unnamed: J9.1, R5.2
unnamed: J9.2, U4.11 (SEL)
unnamed: C4.1, J2.1, L1.2, R1.1
unnamed: J14.1, J27.1, U7.2 (S)
unnamed: J17.1, U6.1 (G), U7.1 (G)
unnamed: J32.12, R35.2
unnamed: J37.1, R32.1, R33.1, R34.1, R36.1
unnamed: C8.1, C10.1, J20.1, TP6.1, U5.7 (VIN)
unnamed: J21.1, U5.5 (ENA)
unnamed: C17.1, J33.2, U9.2 (Vin)
unnamed: J41.1, R37.2, U21.1 (G)
unnamed: J41.4, R38.2
unnamed: J39.1, R38.1, TP8.1, U21.3 (D)
unnamed: C19.1, J47.1, R54.1
unnamed: J47.2, U25.3 (1IN+)
unnamed: J47.4, U25.2 (1IN-)
unnamed: J47.6, U25.1 (1OUT)
unnamed: C20.1, J46.1, U25.8 (VCC)
unnamed: J46.3, U25.7 (2OUT)
unnamed: J46.5, U25.6 (2IN-)
unnamed: J46.7, U25.5 (2IN+)
unnamed: JP1.2 (B), R40.1, R43.1, R47.1, R48.1, R49.1
unnamed: R51.2, R52.1, U2.1 (G), U4.1 (VBUSG), U23.1 (G)
unnamed: R4.1, U1.A5 (CC1), U4.13 (CC1)
unnamed: R2.1, U1.B5 (CC2), U4.12 (CC2)
unnamed: R50.1, R53.2, U24.1 (G)
unnamed: C3.2, U3.1 (BOOT)
unnamed: R1.2, R3.1, TP2.1, U3.4 (VSENSE)
unnamed: C13.1, U8.8 (PF0-OSC_IN), Y1.1
unnamed: C11.1, U8.9 (PF1-OSC_OUT), Y1.2
unnamed: C9.2, U5.1 (BOOT)
unnamed: R6.2, R7.1, TP5.1, U5.4 (VSENSE)
unnamed: R37.1, R39.1, U21.2 (S)
unnamed: R25.1, R26.2, U16.1 (G)
unnamed: R12.1, R23.2, U12.1 (G)
unnamed: R30.2, R31.1, U19.1 (G)
unnamed: R15.2, R16.1, U15.1 (G)
unnamed: R27.2, R29.1, U18.1 (G)
unnamed: R14.2, R18.1, U10.1 (G)
unnamed: R24.2, R28.1, U17.1 (G)
unnamed: R13.1, R19.2, U13.1 (G)
unnamed: R21.2, R22.1, U14.1 (G)
unnamed: R17.2, R20.1, U11.1 (G)
