Sitengwu/IOT_Retro_Display_EEE4022S/STM32G0/Core/Src/main.c

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
/* Includes ------------------------------------------------------------------*/
#include "main.h"

/* USER CODE BEGIN Includes */
#include <stdio.h>
#include <string.h>
/* USER CODE END Includes */

/* USER CODE BEGIN PD */
#define MAX_LED 10

uint8_t LED_Data[MAX_LED][4];
uint8_t LED_Mod[MAX_LED][4];  // for brightness

int datasentflag=0;
/* USER CODE END PD */

TIM_HandleTypeDef htim1;

UART_HandleTypeDef huart2;

/* USER CODE BEGIN PV */
volatile uint8_t interrupted=0;
volatile uint8_t cfgFlag=0;
volatile uint8_t readDigit=0;

uint8_t rx_buffer[20];
uint8_t tx_buffer[20];

uint8_t address;
uint8_t digit;
/* USER CODE END PV */

void SystemClock_Config(void);
static void MX_GPIO_Init(void);
static void MX_TIM1_Init(void);
static void MX_USART2_UART_Init(void);
/* USER CODE BEGIN 0 */

void Set_LED (int LEDnum, int Red, int Green, int Blue)
{
	LED_Data[LEDnum][0] = LEDnum;
	LED_Data[LEDnum][1] = Green;
	LED_Data[LEDnum][2] = Red;
	LED_Data[LEDnum][3] = Blue;
}

void HAL_TIM_PWM_PulseFinishedCallback(TIM_HandleTypeDef *htim)
{
	HAL_TIM_PWM_Stop_DMA(&htim1, TIM_CHANNEL_1);
	datasentflag=1;
}

uint16_t pwmData[(24*MAX_LED)+40];

void WS2812_Send (void)
{
	uint32_t indx=0;
	uint32_t color;

	for (int i= 0; i<MAX_LED; i++)
	{
		color = ((LED_Data[i][1]<<16) | (LED_Data[i][2]<<8) | (LED_Data[i][3]));

		for (int i=23; i>=0; i--)
		{
			if (color&(1<<i))
			{
				pwmData[indx] = 30;  // 2/3 of 90
			}

			else pwmData[indx] = 10;  // 1/3 of 90

			indx++;
		}

	}

	for (int i=0; i<40; i++)
	{
		pwmData[indx] = 0;
		indx++;
	}

	HAL_TIM_PWM_Start_DMA(&htim1, TIM_CHANNEL_1, (uint32_t *)pwmData, indx);
	while (!datasentflag){};
	datasentflag = 0;
}

void toggleLED(int LED, int r, int g, int b)
{
	for (int var = 0; var < MAX_LED; ++var)
	{
		Set_LED(var, 0,0,0);
	}

	WS2812_Send();
	Set_LED(LED, r,g,b);
	WS2812_Send();
}

// Split-Flap code
//void GO(int angle, int delay)
//{
//	int step = angle/0.703125;
//
//	for (int var = 0; var < step; ++var)
//	{
//		HAL_GPIO_TogglePin(GPIOB, IN1_Pin);
//		HAL_GPIO_TogglePin(GPIOB, IN4_Pin);
//		HAL_Delay(delay);
//		HAL_GPIO_TogglePin(GPIOB, IN1_Pin);
//		HAL_GPIO_TogglePin(GPIOB, IN4_Pin);
//		HAL_GPIO_TogglePin(GPIOB, IN4_Pin);
//		HAL_GPIO_TogglePin(GPIOB, IN3_Pin);
//		HAL_Delay(delay);
//		HAL_GPIO_TogglePin(GPIOB, IN4_Pin);
//		HAL_GPIO_TogglePin(GPIOB, IN3_Pin);
//		HAL_GPIO_TogglePin(GPIOB, IN3_Pin);
//		HAL_GPIO_TogglePin(GPIOB, IN2_Pin);
//		HAL_Delay(delay);
//		HAL_GPIO_TogglePin(GPIOB, IN3_Pin);
//		HAL_GPIO_TogglePin(GPIOB, IN2_Pin);
//		HAL_GPIO_TogglePin(GPIOB, IN2_Pin);
//		HAL_GPIO_TogglePin(GPIOB, IN1_Pin);
//		HAL_Delay(delay);
//		HAL_GPIO_TogglePin(GPIOB, IN2_Pin);
//		HAL_GPIO_TogglePin(GPIOB, IN1_Pin);
//	}
//}

//void HAL_GPIO_EXTI_Falling_Callback(uint16_t GPIO_Pin)
//{
//	interrupted=1;
//	HAL_GPIO_TogglePin(GPIOD, GPIO_PIN_1);
//}
/* USER CODE END 0 */

/**
  * @brief  The application entry point.
  * @retval int
  */
int main(void)
{

  /* MCU Configuration--------------------------------------------------------*/

  /* Reset of all peripherals, Initializes the Flash interface and the Systick. */
  HAL_Init();

  /* Configure the system clock */
  SystemClock_Config();

  /* Initialize all configured peripherals */
  MX_GPIO_Init();
  MX_TIM1_Init();
  MX_USART2_UART_Init();
  /* USER CODE BEGIN 2 */

  HAL_UART_Receive_IT(&huart2, rx_buffer, 2);

  for (int var = 0; var < MAX_LED; ++var)
  {
	Set_LED(var, 255,255,255);
  }

  WS2812_Send();



//  HAL_TIM_PWM_Start(&htim1, TIM_CHANNEL_2);

  /* USER CODE END 2 */

  /* Infinite loop */
  /* USER CODE BEGIN WHILE */
  while (1)
  {
	  if(cfgFlag)
	  {
		  toggleLED(address, 0, 0, 0);
		  cfgFlag = 0;
	  }

	  if(readDigit)
	  {
		  toggleLED(digit, 0, 0, 0);
		  readDigit=0;
	  }

	  // Split-Flap Test
//	  GO(90,3);

	  // Flexie Test (still need to reconfigure Timer1 to 10kHz in IOC)
//	  HAL_GPIO_WritePin(GPIOB, GPIO_PIN_10, 0);
//	  HAL_GPIO_WritePin(GPIOA, GPIO_PIN_4, 1);
//	  HAL_Delay(1000);
//	  HAL_GPIO_WritePin(GPIOA, GPIO_PIN_4, 0);
//	  HAL_GPIO_WritePin(GPIOB, GPIO_PIN_10,1);
//	  HAL_Delay(1000);

    /* USER CODE END WHILE */

    /* USER CODE BEGIN 3 */
  }
  /* USER CODE END 3 */
}

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
/* USER CODE BEGIN 4 */
void HAL_UART_RxCpltCallback(UART_HandleTypeDef *huart)
{
	if (huart->Instance == USART2)
	{
		if (rx_buffer[0] == 102)
		{
			address = rx_buffer[1];
			tx_buffer[0] = 102;
			tx_buffer[1] = rx_buffer[1]+1;
			HAL_Delay(100);
			HAL_UART_Transmit_IT(&huart2, tx_buffer, 2);
			HAL_GPIO_WritePin(GPIOA, GPIO_PIN_1, GPIO_PIN_RESET);
			cfgFlag = 1;

			HAL_UART_Receive_IT(&huart2, rx_buffer, 2);
			return;
		}
		if (rx_buffer[0] == 103)
		{
			address = rx_buffer[1];
			tx_buffer[0] = 103;
			tx_buffer[1] = rx_buffer[1]-1;
			HAL_Delay(100);
			HAL_UART_Transmit_IT(&huart2, tx_buffer, 2);
			cfgFlag = 1;

			HAL_UART_Receive_IT(&huart2, rx_buffer, address+1);
			return;
		}
		if (rx_buffer[0] == 104)
		{
			digit = rx_buffer[address];

			for (int var = 0; var < address; ++var)
			{
				tx_buffer[var] = rx_buffer[var];
			}
			HAL_Delay(100);
			HAL_UART_Transmit_IT(&huart2, tx_buffer, address);
			readDigit = 1;

			HAL_UART_Receive_IT(&huart2, rx_buffer, address+1);
			return;
		}

	}
}

/* USER CODE END 4 */
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
