Sitengwu/IOT_Retro_Display_EEE4022S/STM32G0/Core/Inc/main.h

#define LED1_Pin GPIO_PIN_4
#define LED1_GPIO_Port GPIOA
#define LED3_Pin GPIO_PIN_5
#define LED3_GPIO_Port GPIOA
#define LED5_Pin GPIO_PIN_6
#define LED5_GPIO_Port GPIOA
#define LED7_Pin GPIO_PIN_7
#define LED7_GPIO_Port GPIOA
#define LED9_Pin GPIO_PIN_2
#define LED9_GPIO_Port GPIOB
#define LED2_Pin GPIO_PIN_10
#define LED2_GPIO_Port GPIOB
#define LED4_Pin GPIO_PIN_11
#define LED4_GPIO_Port GPIOB
#define LED6_Pin GPIO_PIN_12
#define LED6_GPIO_Port GPIOB
#define LED8_Pin GPIO_PIN_13
#define LED8_GPIO_Port GPIOB
#define LED0_Pin GPIO_PIN_14
#define LED0_GPIO_Port GPIOB
