Sitengwu/IOT_Retro_Display_EEE4022S/(commit log)

2024-07-31 Add new Kicad Files
    [Retro Display Module.kicad_pcb, Retro Display Module.kicad_sch]
2024-09-09 Add: PCB
    [LED Driver.kicad_sch, Power.kicad_sch, RGB_LEDs.kicad_sch, Retro Display Module.kicad_pcb, Retro Display Module.kicad_sch, Timeline.xlsx, USB PD.csv, USB PD.kicad_pcb]
2024-09-09 Added Switch 3D Model
    [Retro Display Module.kicad_pcb]
2024-09-10 Updated USB PD and Driver LED circuit
    [LED Driver.kicad_sch, Power.kicad_sch, RGB_LEDs.kicad_sch, Retro Display Module.kicad_pcb, Retro Display Module.kicad_sch, USB PD.kicad_pcb, USB PD.kicad_sch]
2024-09-10 Updated Display Board schematic and Ltspice simulations
    [LED Driver.kicad_sch, Retro Display Module.kicad_sch]
2024-09-11 Updated Display PCB
    [LED Driver.kicad_sch, Power.kicad_sch, RGB_LEDs.kicad_sch, Retro Display Module.kicad_pcb, Retro Display Module.kicad_sch]
2024-10-01 Begin STM32 Programming
    [AcrylicPane.0001.ipt, AcrylicPane.ipt, DisplayModuleAssembly.0002.iam, DisplayModuleAssembly.iam, DisplayModuleHousing.0009.ipt, DisplayModuleHousing.ipt, LED Driver.kicad_sch, Panelised_PD+Display.kicad_pcb]
2024-11-08 Final Commit for 4022S
    [789_Lines.dwg, 789_Lines.ipt, 789_frame.dwg, 789_frame.ipt, 789outline.dwg, 789outline.ipt, AcrylicPane.0001.ipt, AcrylicPane.ipt]
